KhalidOwlWalid/OwlKit-F103/OwlPCB_Notes/images/Pasted image 20261017075340.png

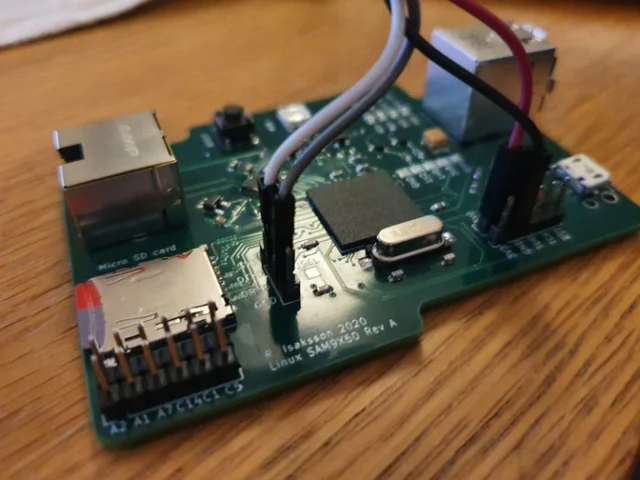
OwlPCB_Notes/images/Pasted image 20261017075340.png
