KhalidOwlWalid/OwlKit-F103/OwlPCB_Notes/First PCB.md

The objective of the first PCB is going to help me understand the embedded world. My learning objectives include:

## Hardware objectives
- SPI breakout
- I2C breakout
- 
- Implementing SPI logic to communicate with MEMS chip (ICM-20948 - 9 axis accelerometer, gyroscope, magnetometer)
- The PCB itself should be able to do CAN
- Use of trice program for debugging
- Debugging with the stm32 cli toolset
- Implementing shell sessions for better debugging capabilities
- Implementing a simple EKF
- USB-C debugging
- Use of SWD header
- Implementing my own bootloader(?) potentially?

The PCB should be able to output  its:
- x,y,z
- roll,pitch,heading

## Design Reference

#### USB-C
- https://hackaday.com/2023/08/07/all-about-usb-c-example-circuits/
