KhalidOwlWalid/OwlKit-F103/OwlPCB_Notes/Needs reviewing.md

# Power budgetting

# USB routing
- It is hard for me to route the USB because they basically overlap each other since each of them basically have 2 pins.
