KhalidOwlWalid/OwlKit-F103/OwlPCB_Notes/images/Pasted image 20261012213644.png

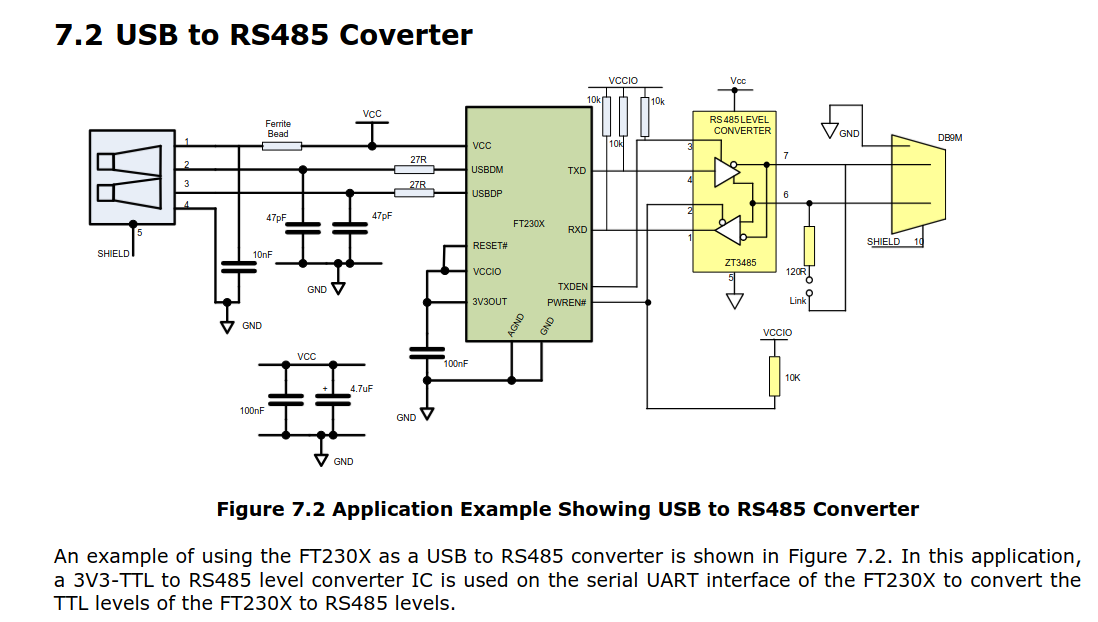
OwlPCB_Notes/images/Pasted image 20261012213644.png
