KhalidOwlWalid/OwlKit-F103/OwlPCB_Notes/images/Pasted image 20261012213755.png

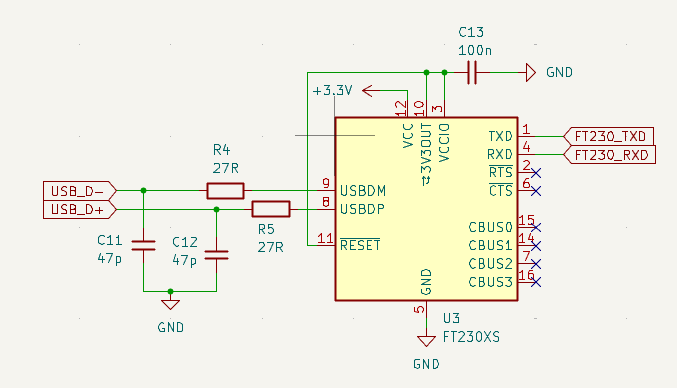
OwlPCB_Notes/images/Pasted image 20261012213755.png
