KhalidOwlWalid/OwlKit-F103/OwlPCB_Notes/images/Pasted image 20261013105958.png

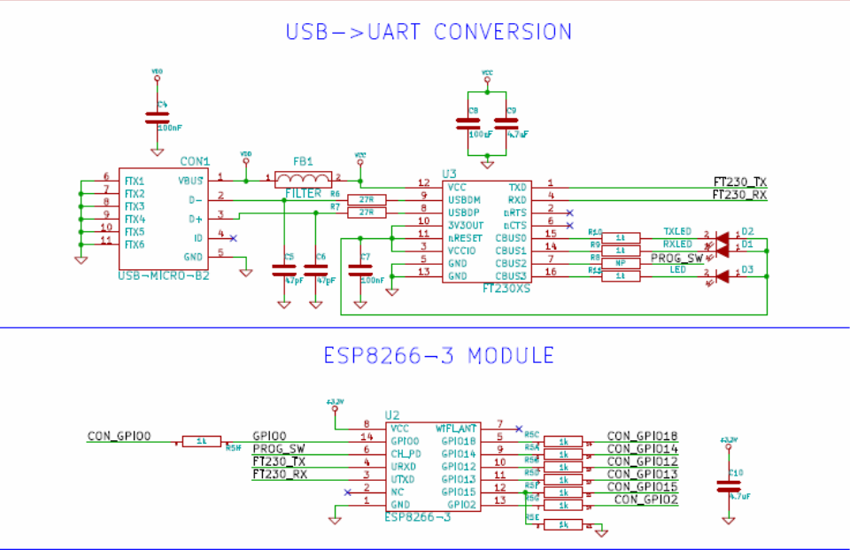
OwlPCB_Notes/images/Pasted image 20261013105958.png
