KhalidOwlWalid/OwlKit-F103/OwlPCB_Notes/images/Pasted image 20261014154300.png

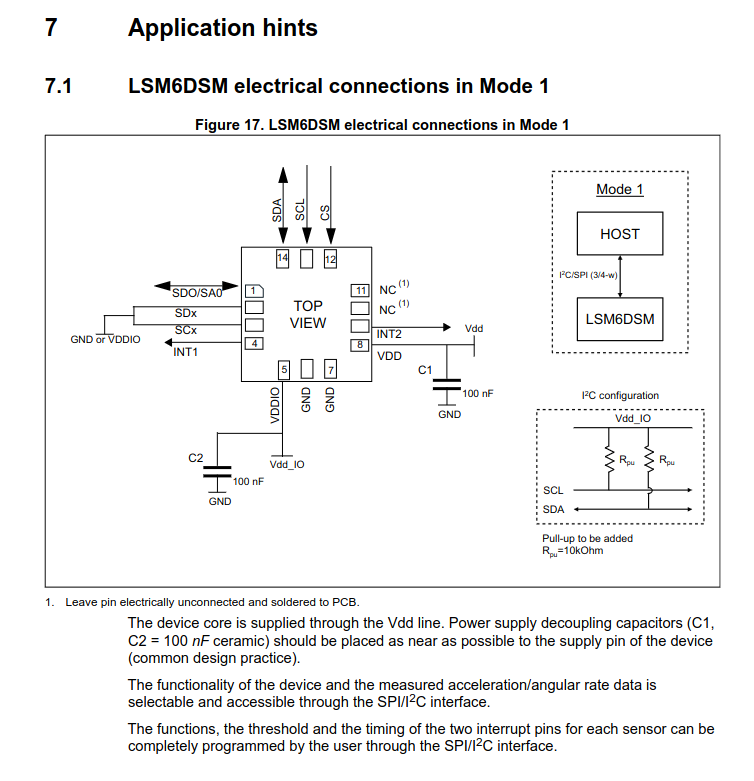
OwlPCB_Notes/images/Pasted image 20261014154300.png
