KhalidOwlWalid/OwlKit-F103/OwlPCB_Notes/images/Pasted image 20261014201545.png

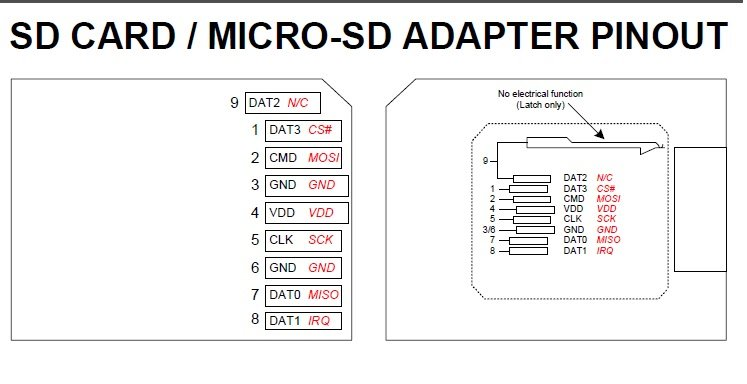
OwlPCB_Notes/images/Pasted image 20261014201545.png
