KhalidOwlWalid/OwlKit-F103/OwlPCB_Notes/images/Pasted image 20261015111348.png

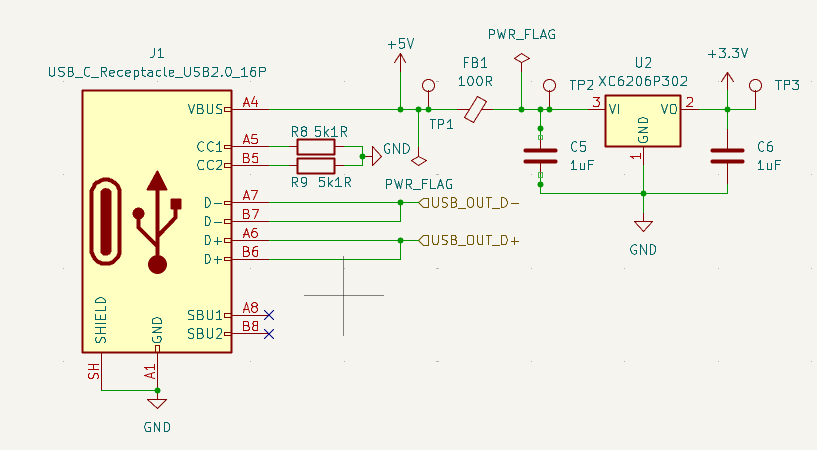
OwlPCB_Notes/images/Pasted image 20261015111348.png
