KhalidOwlWalid/OwlKit-F103/OwlPCB_Notes/images/Pasted image 20261015134140.png

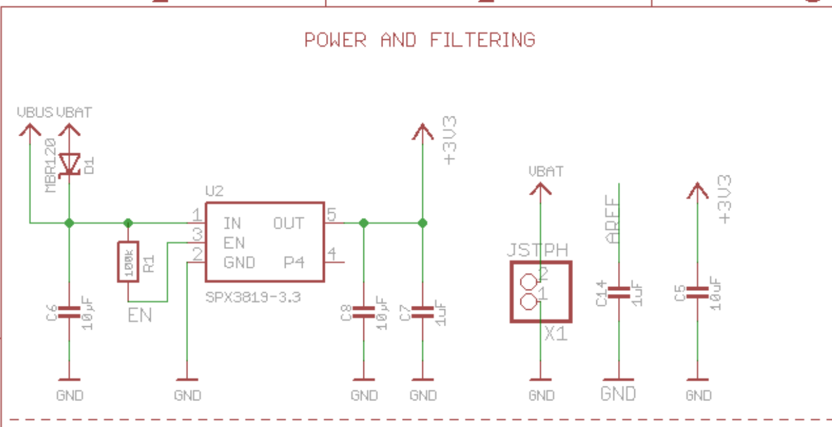
OwlPCB_Notes/images/Pasted image 20261015134140.png
