KhalidOwlWalid/OwlKit-F103/3d/SW_SPDT_CK_JS102011SAQN.STEP

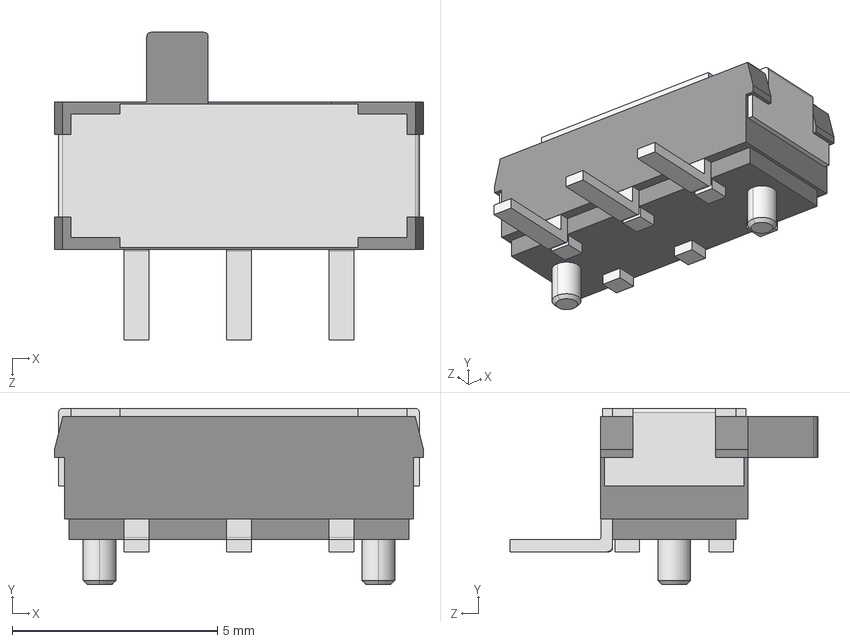
[picture p17: CAD file, 2026-11-11]
3d/SW_SPDT_CK_JS102011SAQN.STEP
9.00 x 4.30 x 7.50 mm
