KhalidOwlWalid/OwlKit-F103/owl_v1.kicad_pcb

## KiCad design owl_v1.kicad_pcb (2026-11-12)

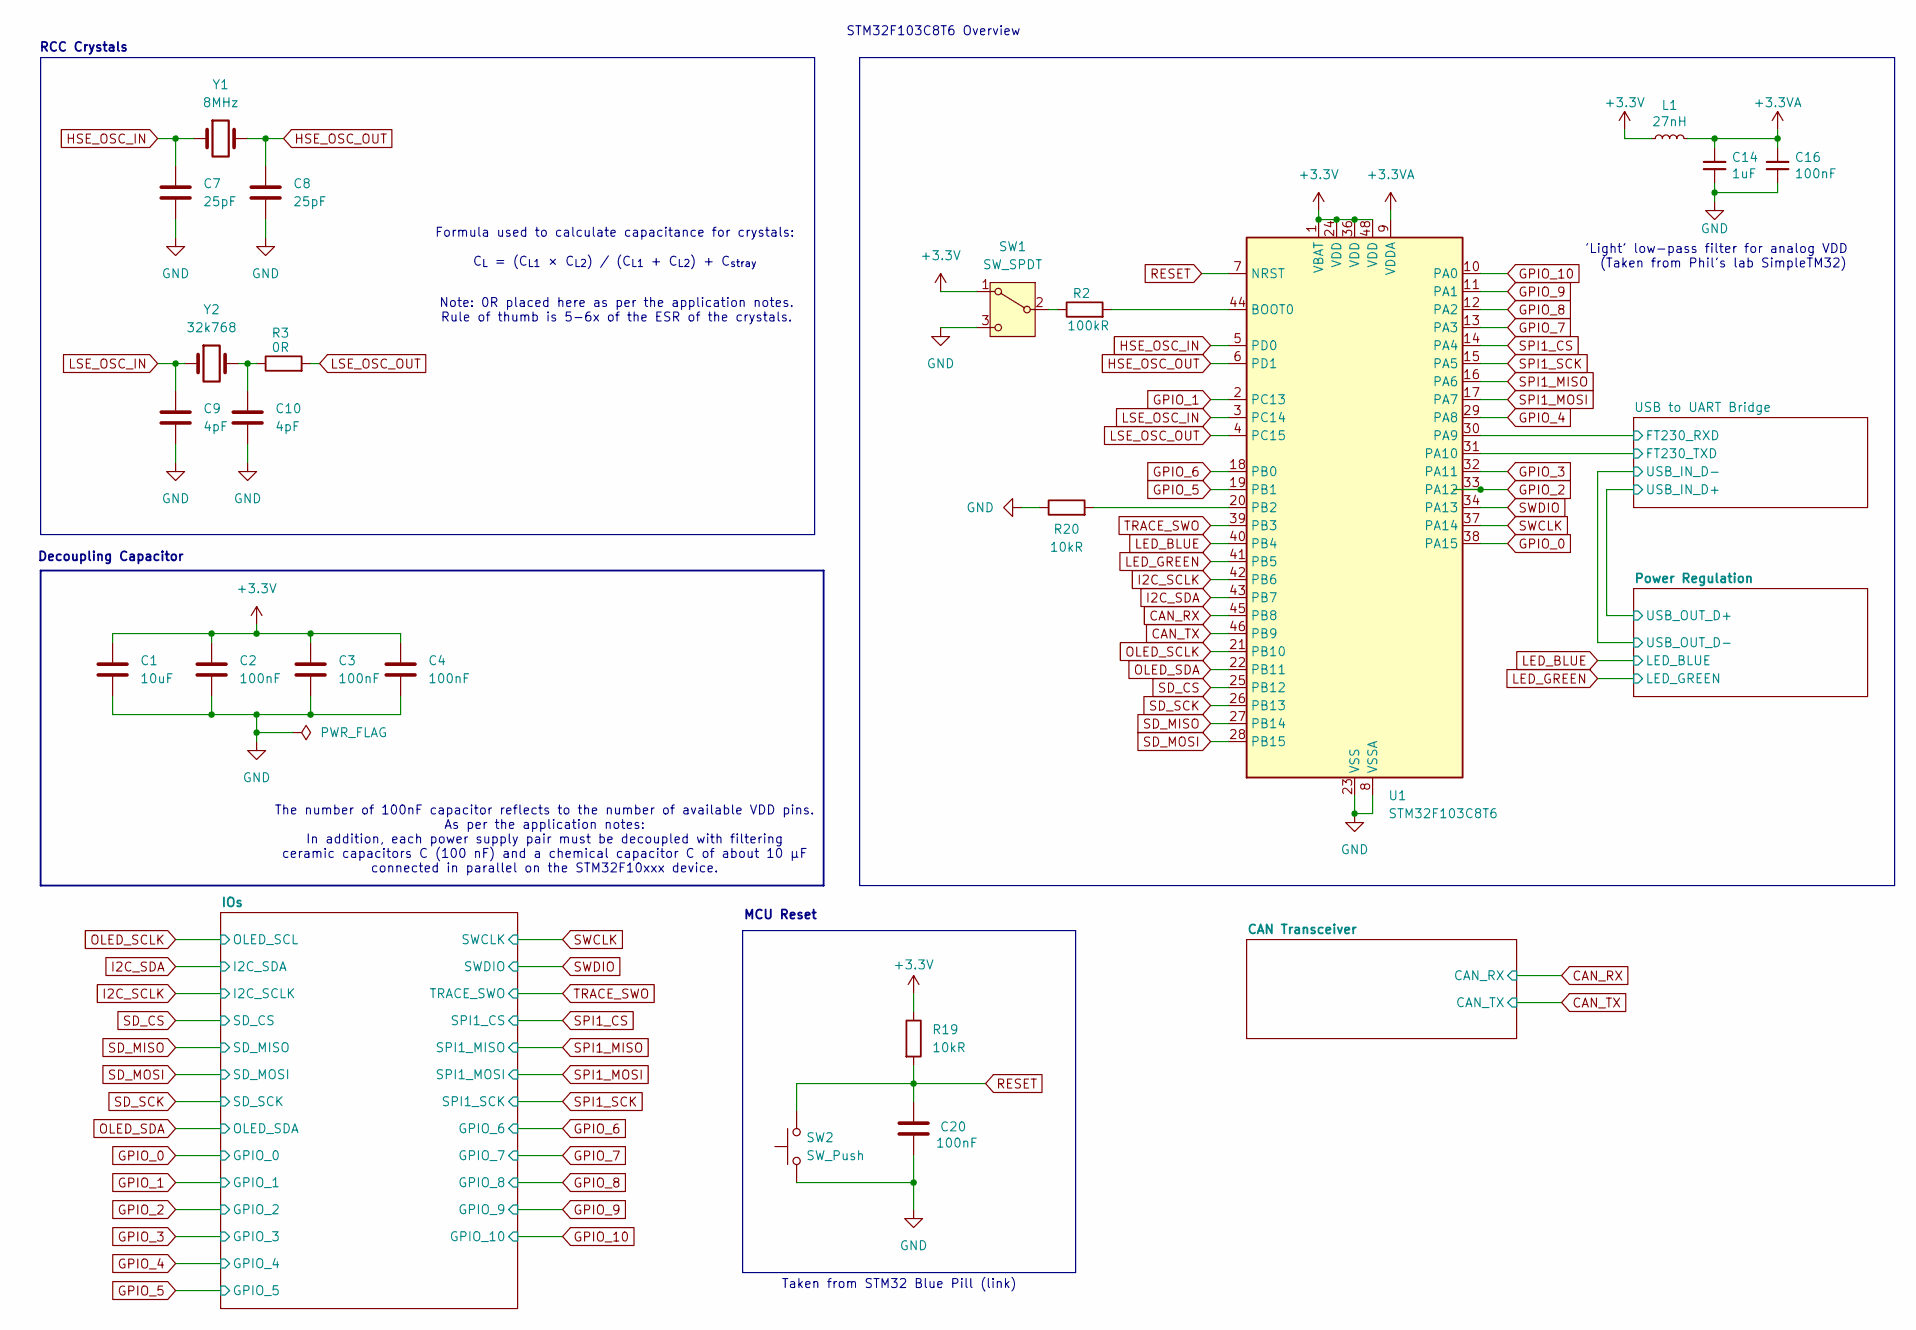
[picture p24: schematic owl_v1.kicad_sch]

Parts:
C1: 10uF; C_0603_1608Metric
C2, C3, C4, C20: 100nF; C_0603_1608Metric
C7, C8: 25pF; C_0603_1608Metric
C9, C10: 4pF; C_0603_1608Metric
C14: 1uF; C_0603_1608Metric; LCSC Part # C52923
C16: 100nF; C_0603_1608Metric; LCSC Part # C1525
L1: 27nH; L_0603_1608Metric; LCSC Part # C18830
R2: 100kR; R_0603_1608Metric
R3: 0R; R_0603_1608Metric
R19, R20: 10kR; R_0603_1608Metric
SW1: SW_SPDT; SW_SPDT_CK_JS102011SAQN
SW2: SW_Push; SW_PUSH_6mm
U1: STM32F103C8T6; LQFP-48_7x7mm_P0.5mm
Y1: 8MHz; Crystal_SMD_HC49-SD
Y2: 32k768; Crystal_SMD_MicroCrystal_CC8V-T1A-2Pin_2.0x1.2mm_HandSolder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

Connections:
+3.3V: C1.1, C2.1, C3.1, C4.1, L1.1, R19.1, SW1.1 (A), U1.1 (VBAT), U1.24 (VDD), U1.36 (VDD), U1.48 (VDD); also elsewhere on the board
+3.3VA: C14.1, C16.1, L1.2, U1.9 (VDDA)
/owl_v1/USB to UART Bridge/FT230_RXD: U1.30 (PA9); also elsewhere on the board
/owl_v1/USB to UART Bridge/FT230_TXD: U1.31 (PA10); also elsewhere on the board
CAN_RX: U1.45 (PB8); also elsewhere on the board
CAN_TX: U1.46 (PB9); also elsewhere on the board
GND: C1.2, C2.2, C3.2, C4.2, C7.2, C8.2, C9.2, C10.2, C14.2, C16.2, C20.1, R20.1, SW1.3 (C), SW2.1, U1.8 (VSSA), U1.23 (VSS), U1.35 (VSS), U1.47 (VSS); also elsewhere on the board
GPIO_0: U1.38 (PA15); also elsewhere on the board
GPIO_1: U1.2 (PC13); also elsewhere on the board
GPIO_2: U1.33 (PA12); also elsewhere on the board
GPIO_3: U1.32 (PA11); also elsewhere on the board
GPIO_4: U1.29 (PA8); also elsewhere on the board
GPIO_5: U1.19 (PB1); also elsewhere on the board
GPIO_6: U1.18 (PB0); also elsewhere on the board
GPIO_7: U1.13 (PA3); also elsewhere on the board
GPIO_8: U1.12 (PA2); also elsewhere on the board
GPIO_9: U1.11 (PA1); also elsewhere on the board
GPIO_10: U1.10 (PA0); also elsewhere on the board
HSE_OSC_IN: C7.1, U1.5 (PD0), Y1.1
HSE_OSC_OUT: C8.1, U1.6 (PD1), Y1.2
I2C_SCLK: U1.42 (PB6); also elsewhere on the board
I2C_SDA: U1.43 (PB7); also elsewhere on the board
LED_BLUE: U1.40 (PB4); also elsewhere on the board
LED_GREEN: U1.41 (PB5); also elsewhere on the board
LSE_OSC_IN: C9.1, U1.3 (PC14), Y2.1
LSE_OSC_OUT: R3.2, U1.4 (PC15)
unnamed: C10.1, R3.1, Y2.2
unnamed: R2.1, SW1.2 (B)
unnamed: R2.2, U1.44 (BOOT0)
unnamed: R20.2, U1.20 (PB2)
OLED_SCLK: U1.21 (PB10); also elsewhere on the board
OLED_SDA: U1.22 (PB11); also elsewhere on the board
RESET: C20.2, R19.2, SW2.2, U1.7 (NRST)
SD_CS: U1.25 (PB12); also elsewhere on the board
SD_MISO: U1.27 (PB14); also elsewhere on the board
SD_MOSI: U1.28 (PB15); also elsewhere on the board
SD_SCK: U1.26 (PB13); also elsewhere on the board
SPI1_CS: U1.14 (PA4); also elsewhere on the board
SPI1_MISO: U1.16 (PA6); also elsewhere on the board
SPI1_MOSI: U1.17 (PA7); also elsewhere on the board
SPI1_SCK: U1.15 (PA5); also elsewhere on the board
SWCLK: U1.37 (PA14); also elsewhere on the board
SWDIO: U1.34 (PA13); also elsewhere on the board
TRACE_SWO: U1.39 (PB3); also elsewhere on the board

Notes on the sheet:
MCU Reset
Formula used to calculate capacitance for crystals: C_{L} = (C_{L1} × C_{L2}) / (C_{L1} + C_{L2}) + C_{stray}
RCC Crystals
STM32F103C8T6 Overview
The number of 100nF capacitor reflects to the number of available VDD pins. As per the application notes: In addition, each power supply pair must be decoupled with filtering ceramic capacitors C (100 nF) and a chemical capacitor C of about 10 μF connected in parallel on the STM32F10xxx device.
Decoupling Capacitor
Taken from STM32 Blue Pill (link)
Note: 0R placed here as per the application notes. Rule of thumb is 5-6x of the ESR of the crystals.
'Light' low-pass filter for analog VDD (Taken from Phil's lab SimpleTM32)

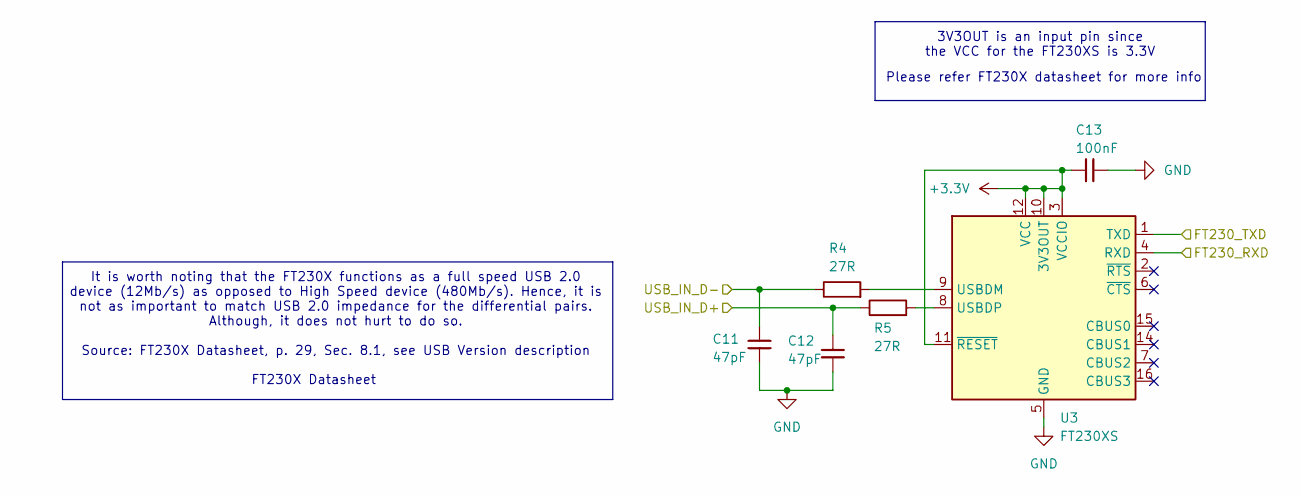
[picture p25: schematic usb_to_uart.kicad_sch]

Parts:
C11, C12: 47pF; C_0603_1608Metric
C13: 100nF; C_0603_1608Metric
R4, R5: 27R; R_0603_1608Metric
U3: FT230XS; SSOP-16_3.9x4.9mm_P0.635mm

Connections:
+3.3V: C13.2, U3.3 (VCCIO), U3.10 (3V3OUT), U3.11 (~RESET), U3.12 (VCC); also elsewhere on the board
/owl_v1/Power Regulation/USB_OUT_D+: C12.1, R5.1; also elsewhere on the board
/owl_v1/Power Regulation/USB_OUT_D-: C11.1, R4.1; also elsewhere on the board
/owl_v1/USB to UART Bridge/FT230_RXD: U3.4 (RXD); also elsewhere on the board
/owl_v1/USB to UART Bridge/FT230_TXD: U3.1 (TXD); also elsewhere on the board
GND: C11.2, C12.2, C13.1, U3.5 (GND), U3.13 (GND); also elsewhere on the board
unnamed: R4.2, U3.9 (USBDM)
unnamed: R5.2, U3.8 (USBDP)

Notes on the sheet:
Please refer FT230X datasheet for more info
3V3OUT is an input pin since the VCC for the FT230XS is 3.3V
FT230X Datasheet
It is worth noting that the FT230X functions as a full speed USB 2.0 device (12Mb/s) as opposed to High Speed device (480Mb/s). Hence, it is not as important to match USB 2.0 impedance for the differential pairs. Although, it does not hurt to do so. Source: FT230X Datasheet, p. 29, Sec. 8.1, see US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

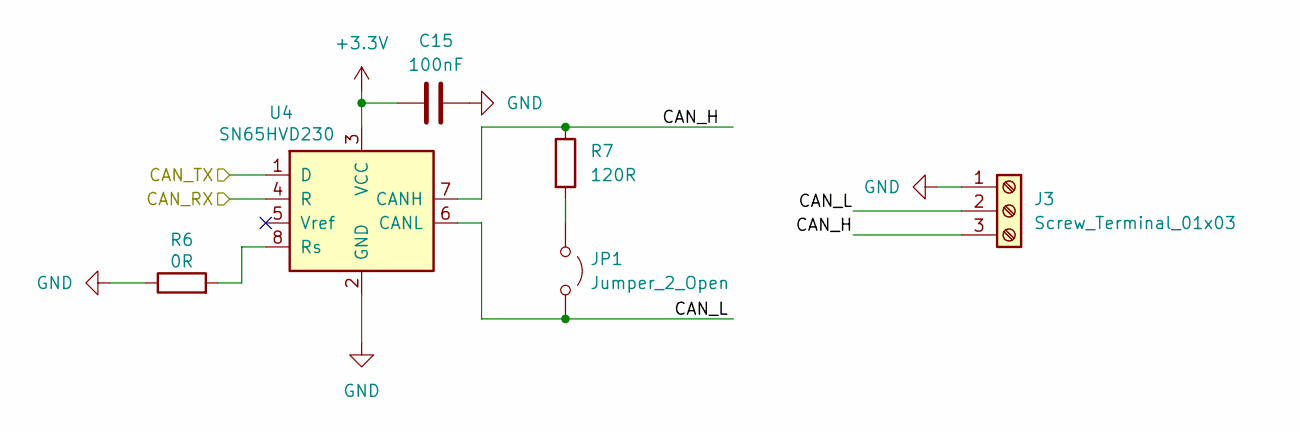
[picture p26: schematic can_controller.kicad_sch]

Parts:
C15: 100nF; C_0603_1608Metric
J3: Screw_Terminal_01x03; TerminalBlock_Phoenix_PT-1,5-3-3.5-H_1x03_P3.50mm_Horizontal
JP1: Jumper_2_Open; PinHeader_1x02_P2.54mm_Vertical
R6: 0R; R_0603_1608Metric
R7: 120R; R_0603_1608Metric
U4: SN65HVD230; SOIC-8_3.9x4.9mm_P1.27mm

Connections:
+3.3V: C15.1, U4.3 (VCC); also elsewhere on the board
/owl_v1/CAN Transceiver/CAN_H: J3.3, R7.1, U4.7 (CANH)
/owl_v1/CAN Transceiver/CAN_L: J3.2, JP1.2 (B), U4.6 (CANL)
CAN_RX: U4.4 (R); also elsewhere on the board
CAN_TX: U4.1 (D); also elsewhere on the board
GND: C15.2, J3.1, R6.1, U4.2 (GND); also elsewhere on the board
unnamed: JP1.1 (A), R7.2
unnamed: R6.2, U4.8 (Rs)

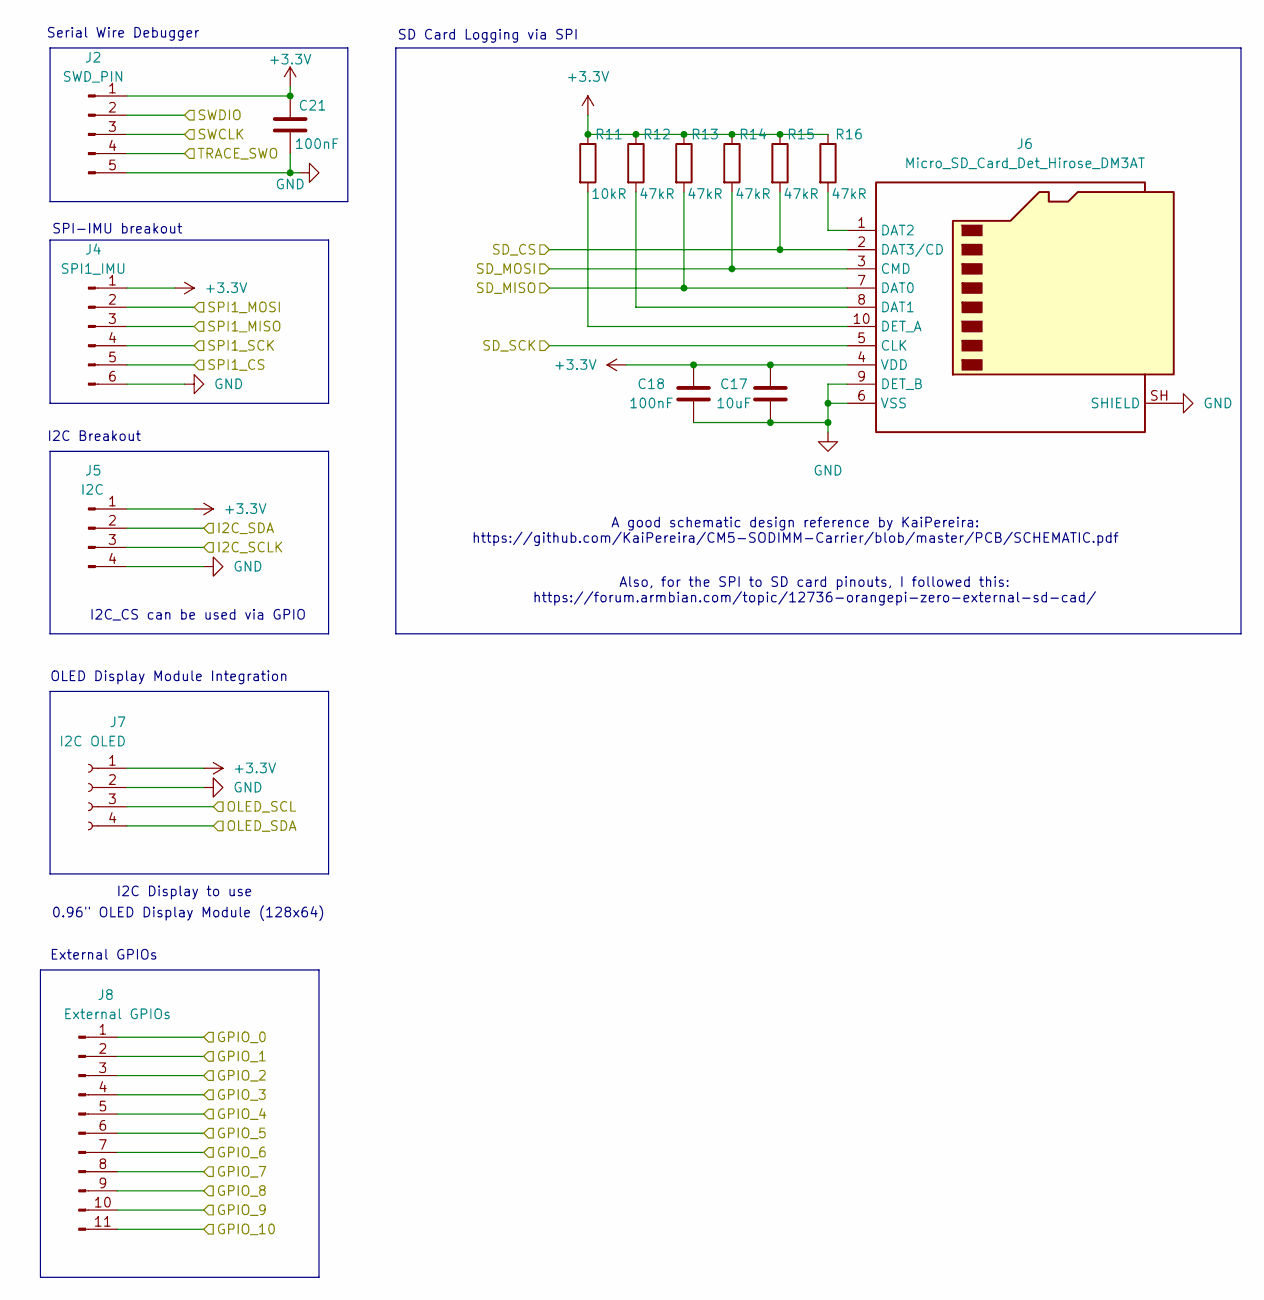
[picture p27: schematic GPIOs.kicad_sch]

Parts:
C17: 10uF; C_0603_1608Metric
C18, C21: 100nF; C_0603_1608Metric
J2: SWD_PIN; PinHeader_1x05_P2.54mm_Vertical
J4: SPI1_IMU; PinHeader_1x06_P2.54mm_Vertical
J5: I2C; PinHeader_1x04_P2.54mm_Vertical
J6: Micro_SD_Card_Det_Hirose_DM3AT; microSD_HC_Hirose_DM3AT-SF-PEJM5
J7: I2C OLED; PinSocket_1x04_P2.54mm_Vertical
J8: External GPIOs; PinHeader_1x11_P2.54mm_Vertical
R11: 10kR; R_0603_1608Metric
R12, R13, R14, R15, R16: 47kR; R_0603_1608Metric

Connections:
+3.3V: C17.1, C18.1, C21.1, J2.1, J4.1, J5.1, J6.4 (VDD), J7.1, R11.1, R12.1, R13.1, R14.1, R15.1, R16.1; also elsewhere on the board
GND: C17.2, C18.2, C21.2, J2.5, J4.6, J5.4, J6.6 (VSS), J6.9 (DET_B), J6.SH (SHIELD), J7.2; also elsewhere on the board
GPIO_0: J8.1; also elsewhere on the board
GPIO_1: J8.2; also elsewhere on the board
GPIO_2: J8.3; also elsewhere on the board
GPIO_3: J8.4; also elsewhere on the board
GPIO_4: J8.5; also elsewhere on the board
GPIO_5: J8.6; also elsewhere on the board
GPIO_6: J8.7; also elsewhere on the board
GPIO_7: J8.8; also elsewhere on the board
GPIO_8: J8.9; also elsewhere on the board
GPIO_9: J8.10; also elsewhere on the board
GPIO_10: J8.11; also elsewhere on the board
I2C_SCLK: J5.3; also elsewhere on the board
I2C_SDA: J5.2; also elsewhere on the board
unnamed: J6.8 (DAT1), R12.2
unnamed: J6.1 (DAT2), R16.2
unnamed: J6.10 (DET_A), R11.2
OLED_SCLK: J7.3; also elsewhere on the board
OLED_SDA: J7.4; also elsewhere on the board
SD_CS: J6.2 (DAT3/CD), R15.2; also elsewhere on the board
SD_MISO: J6.7 (DAT0), R13.2; also elsewhere on the board
SD_MOSI: J6.3 (CMD), R14.2; also elsewhere on the board
SD_SCK: J6.5 (CLK); also elsewhere on the board
SPI1_CS: J4.5; also elsewhere on the board
SPI1_MISO: J4.3; also elsewhere on the board
SPI1_MOSI: J4.2; also elsewhere on the board
SPI1_SCK: J4.4; also elsewhere on the board
SWCLK: J2.3; also elsewhere on the board
SWDIO: J2.2; also elsewhere on the board
TRACE_SWO: J2.4; also elsewhere on the board

Notes on the sheet:
Also, for the SPI to SD card pinouts, I followed this: https://forum.armbian.com/topic/12736-orangepi-zero-external-sd-cad/
Serial Wire Debugger
External GPIOs
SD Card Logging via SPI
0.96" OLED Display Module (128x64)
I2C Breakout
I2C_CS can be used via GPIO
SPI-IMU breakout
OLED Display Module Integration
I2C Display to use
A good schematic design reference by KaiPereira: https://github.com/KaiPereira/CM5-SODIMM-Carrier/blob/master/PCB/SCHEMATIC.pdf

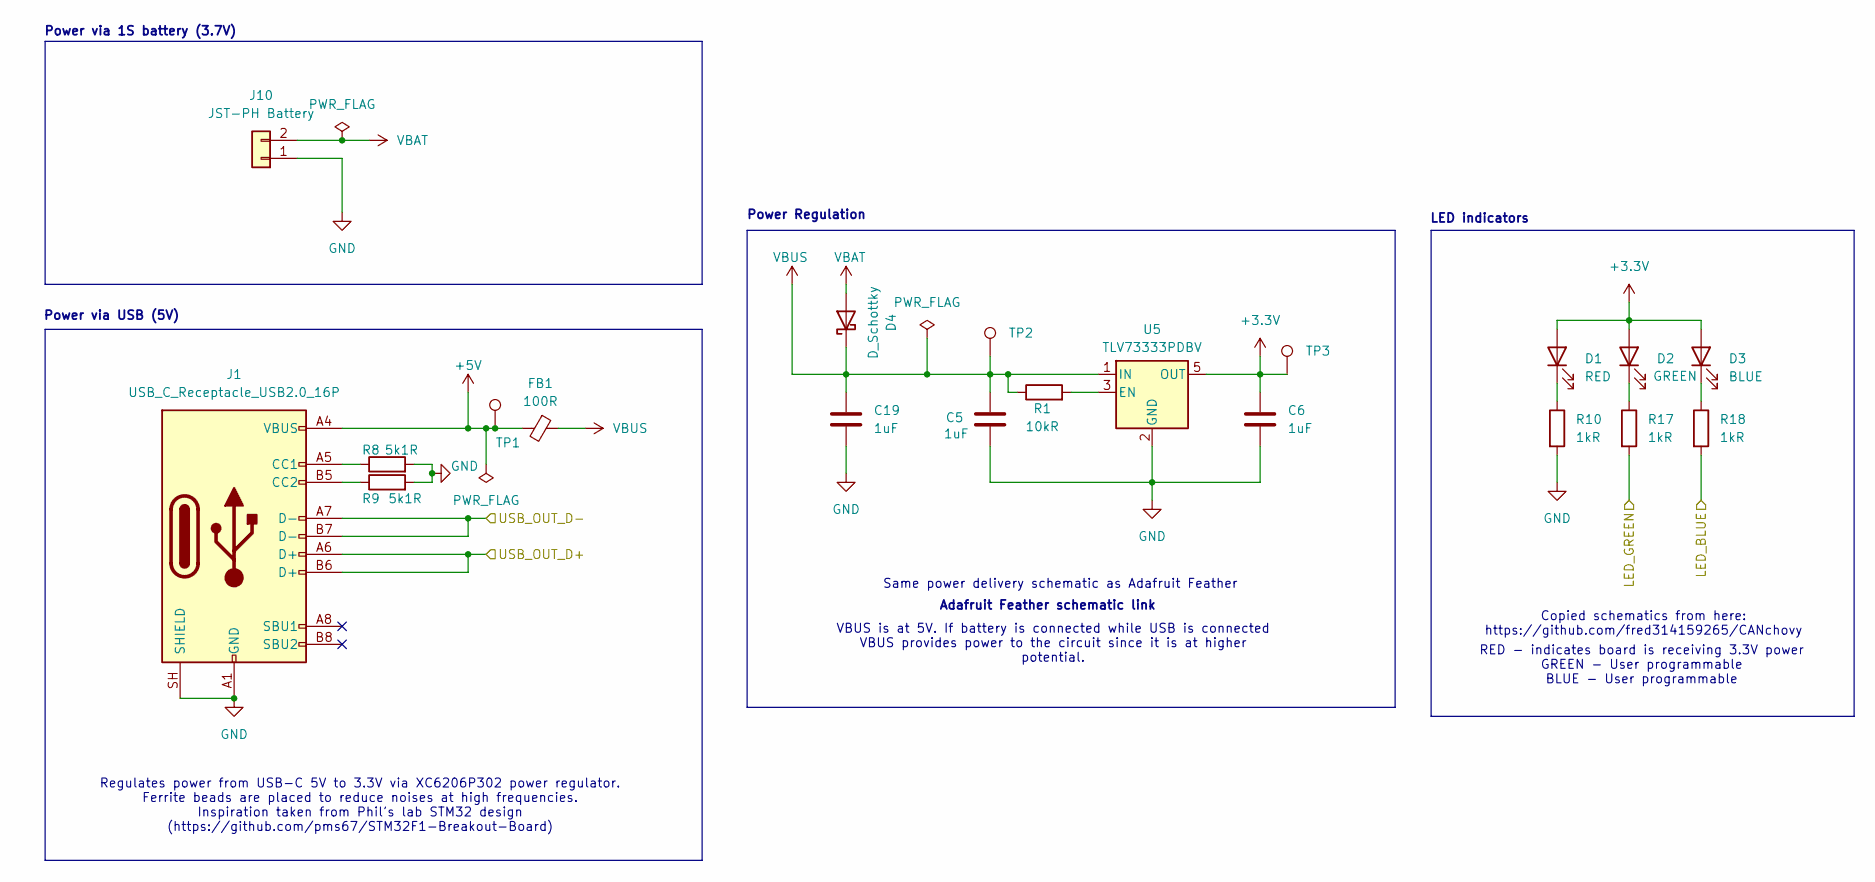
[picture p28: schematic usb_power_regulator.kicad_sch]

Parts:
C5, C6, C19: 1uF; C_0603_1608Metric
D1: RED; LED_0603_1608Metric
D2: GREEN; LED_0603_1608Metric
D3: BLUE; LED_0603_1608Metric
D4: D_Schottky; D_0603_1608Metric
FB1: 100R; L_0603_1608Metric
J1: USB_C_Receptacle_USB2.0_16P; USB_C_Receptacle_GCT_USB4105-xx-A_16P_TopMnt_Horizontal
J10: JST-PH Battery; JST_PH_S2B-PH-K_1x02_P2.00mm_Horizontal
R1: 10kR; R_0603_1608Metric
R8, R9: 5k1R; R_0603_1608Metric
R10, R17, R18: 1kR; R_0603_1608Metric
TP1, TP2, TP3: TestPoint_Pad_D1.5mm
U5: TLV73333PDBV; SOT-23-5

Connections:
+3.3V: C6.1, D1.2 (A), D2.2 (A), D3.2 (A), TP3.1 (1_1), U5.5 (OUT); also elsewhere on the board
+5V: FB1.2, J1.A4 (VBUS), J1.A9 (VBUS), J1.B4 (VBUS), J1.B9 (VBUS), TP1.1 (1_1)
/owl_v1/Power Regulation/USB_OUT_D+: J1.A6 (D+), J1.B6 (D+); also elsewhere on the board
/owl_v1/Power Regulation/USB_OUT_D-: J1.A7 (D-), J1.B7 (D-); also elsewhere on the board
GND: C5.2, C6.2, C19.2, J1.A1 (GND), J1.A12 (GND), J1.B1 (GND), J1.B12 (GND), J1.SH (SHIELD), J10.1, R8.2, R9.2, R10.2, U5.2 (GND); also elsewhere on the board
LED_BLUE: R18.2; also elsewhere on the board
LED_GREEN: R17.2; also elsewhere on the board
unnamed: D1.1 (K), R10.1
unnamed: D2.1 (K), R17.1
unnamed: D3.1 (K), R18.1
unnamed: J1.A5 (CC1), R8.1
unnamed: J1.B5 (CC2), R9.1
unnamed: R1.2, U5.3 (EN)
VBAT: D4.2 (A), J10.2
VBUS: C5.1, C19.1, D4.1 (K), FB1.1, R1.1, TP2.1 (1_1), U5.1 (IN)

Notes on the sheet:
VBUS is at 5V. If battery is connected while USB is connected VBUS provides power to the circuit since it is at higher potential.
Same power delivery schematic as Adafruit Feather
LED indicators
RED - indicates board is receiving 3.3V power GREEN - User programmable BLUE - User programmable
Regulates power from USB-C 5V to 3.3V via XC6206P302 power regulator. Ferrite beads are placed to reduce noises at high frequencies. Inspiration taken from Phil's lab STM32 design (https://github.com/pms67/STM32F1-Breakout-Board)
Copied schematics from here: https://github.com/fred314159265/CANchovy
Power via USB (5V)
Power Regulation
Power via 1S battery (3.7V)
Adafruit Feather schematic link

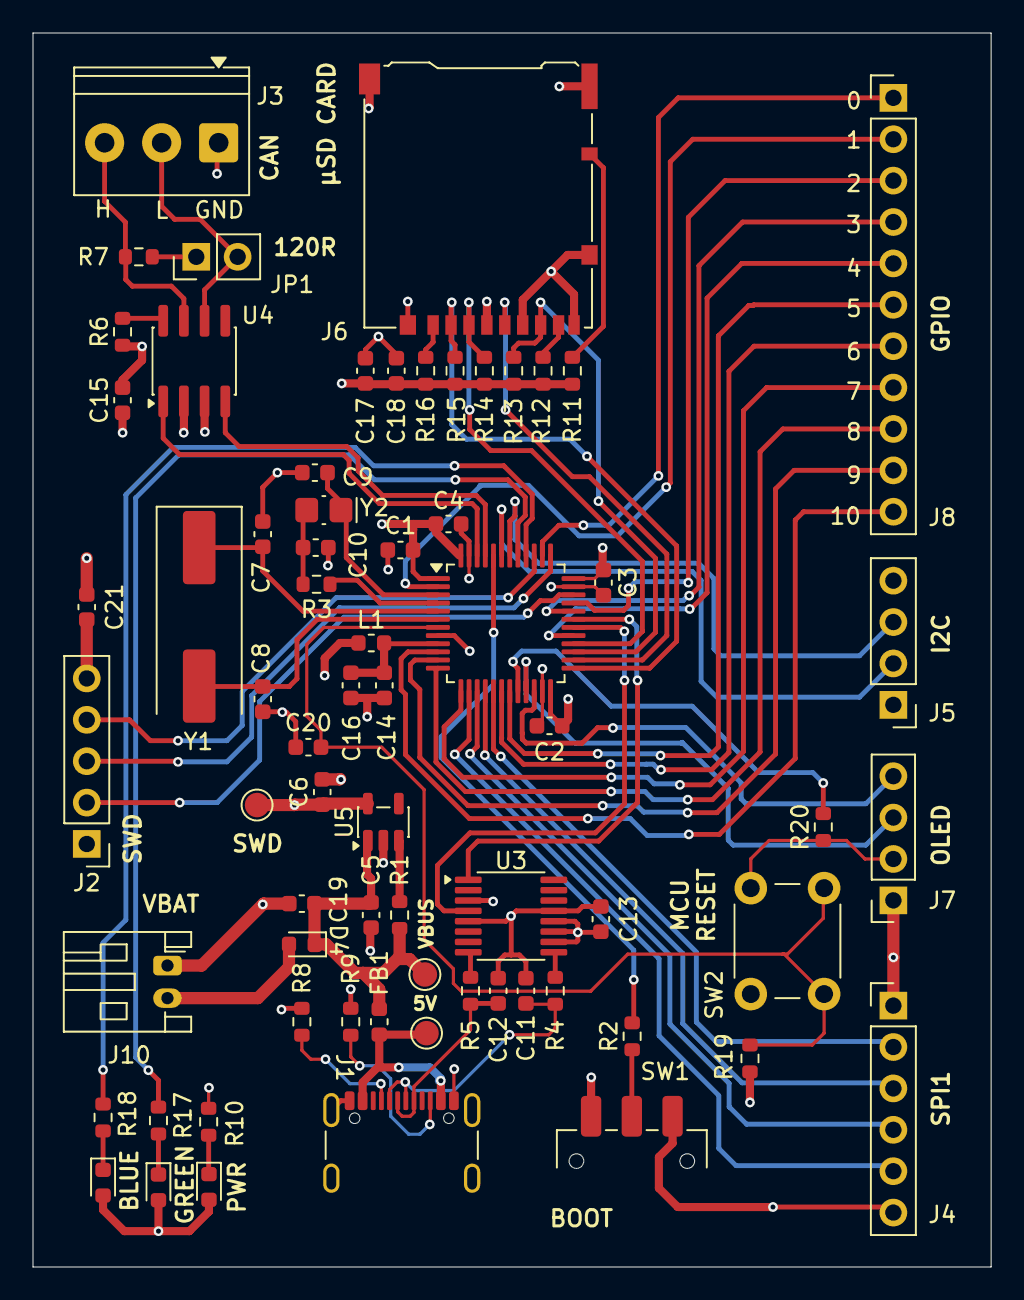
[picture p29: board owl_v1.kicad_pcb from above]

Board: 4 copper layers, 58.8 x 75.7 mm, 69 parts (1 on the bottom side), 64 nets.

Other parts of the board:
Owl Kit v0.1: LOGO
