KhalidOwlWalid/OwlKit-F103/(commit log)

2026-10-11 [chore] Initial commit
    [owl_v1.kicad_pcb, owl_v1.kicad_sch, untitled.kicad_sch]
2026-10-11 [feat] Add boot pin switch
    [owl_v1.kicad_sch]
2026-10-11 [chore] Add comments on why decoupling capacitor is used
    [owl_v1.kicad_sch]
2026-10-11 [feat] Integrate HSE and LSE crystal, populate global label for SWD
    [owl_v1.kicad_sch]
2026-10-11 [feat] Add HSE and LSE crystals for RCC
    [owl_v1.kicad_sch]
2026-10-12 [feat] Initial implementation of usb-uart bridge with FT230
    [owl_v1.kicad_sch, usb_uart.kicad_sch]
2026-10-13 [usb-uart] Connects VCC with 3V3OUT and VCCIO
    This needs to be done because FT230X is provided with 3.3V, if 3.3V is
    provided, as per the datasheet, 3V3OUT becomes an input and requires
    3.3V input. VCCIO now also needs to be fed with the same 3.3V as per the
    schematic. Although, in the schematic, VCC is not directly connected,
    but that is because in the RS485 application schematic, VCC is driven by
    5V and not 3.3V.
    [usb_uart.kicad_sch]
2026-10-13 [refactor] Refactor the schematics to use sub-sheets
    [GPIOs.kicad_sch, owl_v1.kicad_sch, sensors.kicad_sch, usb_power_regulator.kicad_sch, usb_to_uart.kicad_sch, usb_uart.kicad_sch]
2026-10-13 [feat] Add CAN transceiver SN65VHD230
    Also ran ERC checks and add some exclusion ERC for the FT230XS due to
    3V3OUT being an input pin rather than output pin
    [GPIOs.kicad_sch, can_controller.kicad_sch, owl_v1.kicad_sch, usb_power_regulator.kicad_sch, usb_to_uart.kicad_sch]
2026-10-13 [refactor] Change the CAN Tx and Rx from global to hierarchical label
    [can_controller.kicad_sch, owl_v1.kicad_sch]
2026-10-14 [feat] Add breakout for SPI1 for IMU
    [GPIOs.kicad_sch, owl_v1.kicad_sch, usb_power_regulator.kicad_sch]
2026-10-14 [feat] Add analogue filter
    The analogue filter has been copied from Phil's lab SimpleTM32
    [design_notes.kicad_sch, owl_v1.kicad_sch]
2026-10-14 [feat] Integrate MicroSD Card into the board with SPI2
    [GPIOs.kicad_sch, can_controller.kicad_sch, owl_v1.kicad_sch, usb_power_regulator.kicad_sch, usb_to_uart.kicad_sch]
2026-10-14 [fix] Add 5.1kR to CC1 and CC2 USB
    USB-C specification requires CC1 and CC2 to be connected to ground via a
    resistor for USB-C to USB-C power to work.
    [owl_v1.kicad_pcb, usb_power_regulator.kicad_sch]
2026-10-14 [feat] Add I2C breakout
    [GPIOs.kicad_sch, design_notes.kicad_sch, owl_v1.kicad_sch, usb_power_regulator.kicad_sch]
2026-10-15 [feat] Add OLED I2C breakout for display, Add general purpose GPIOs
    [GPIOs.kicad_sch, design_notes.kicad_sch, owl_v1.kicad_pcb, owl_v1.kicad_sch, usb_power_regulator.kicad_sch, usb_to_uart.kicad_sch]
2026-10-15 [feat] Add footprints for external GPIOs
    [GPIOs.kicad_sch, owl_v1.kicad_sch]
2026-10-15 [refactor] Remove GPIO12 and GPIO13 for LED green and blue
    [GPIOs.kicad_sch, design_notes.kicad_sch, owl_v1.kicad_pcb, owl_v1.kicad_sch]
2026-10-15 [feat] Integrate external battery
    [GPIOs.kicad_sch, changelog.kicad_sch, design_notes.kicad_sch, owl_v1.kicad_pcb, owl_v1.kicad_sch, usb_power_regulator.kicad_sch, usb_to_uart.kicad_sch]
2026-10-16 [feat] Initial routing for the owl PCB
    [owl_v1.kicad_pcb, owl_v1.kicad_sch, usb_power_regulator.kicad_sch, usb_to_uart.kicad_sch]
2026-10-16 [feat] Finished routing power regulation
    [owl_v1.kicad_pcb]
2026-10-16 [refactor] Change pinouts for CAN screw terminal
    I need to change this because I am struggling to route this in the pcb
    editor
    [GPIOs.kicad_sch, can_controller.kicad_sch, owl_v1.kicad_pcb]
2026-10-17 [checkpoint] Checkpoint before I mess up my routing for the micro SD card
    [owl_v1.kicad_pcb]
2026-10-18 [checkpoint] Change from 2 layer to 4 layer PCB
    [GPIOs.kicad_sch, owl_v1.kicad_pcb]
2026-10-19 [feat] Routing for FT230X USB-UART
    [owl.kicad_sch, owl_v1.kicad_pcb, test.kicad_sch, untitled.kicad_sch, usb_to_uart.kicad_sch]
2026-10-19 [feat] Finished re-routing HSE, LSE and 3.3VA
    [owl_v1.kicad_pcb]
2026-10-19 [refactor] Board resizing, SWD moved to fit left side of the board
    [owl_v1.kicad_pcb]
2026-10-19 [feat] Finished routing for uSD card reader
    [owl_v1.kicad_pcb]
2026-10-19 [feat] Route most GPIO pins and SWD pins
    [owl_v1.kicad_pcb, owl_v1.kicad_sch]
2026-10-19 [feat] Connect 3.3V source to all pins requiring 3.3V
    [owl_v1.kicad_pcb]
2026-10-19 [refactor] Change how GPIO is routed
    [owl_v1.kicad_pcb]
2026-10-19 [refactor] Expanded the board to get more GPIOs to fit
    [owl_v1.kicad_pcb, owl_v1.kicad_sch]
2026-10-19 [chore] Cleanup GPIOs routing
    [owl_v1.kicad_pcb]
2026-10-19 [fix] Change the board setup constraints which I thought was already correct?
    [owl_v1.kicad_pcb]
2026-10-19 [fix] Change vias settings
    Change minimum diameter from 0.7mm to 0.6mm with 0.3mm hole size
    [owl_v1.kicad_pcb]
2026-10-20 [feat] Add custom design rule check for JLCPCB, finished routing the whole thing, DRC all clear
    Taken from here (https://github.com/labtroll/KiCad-DesignRules)
    [owl_v1.kicad_pcb]
2026-10-20 [feat] Add owl logo
    [owl_v1.kicad_pcb]
2026-10-20 [chore] Add labels with front silkscreen
    [owl_v1.kicad_pcb]
2026-11-11 [bugfix] Fix BOOT1 pin which was GPIO11, now have a pull-down
    [GPIOs.kicad_sch, owl_v1.kicad_sch]
2026-11-11 [chore] Change symbol and update schematic properly
    [GPIOs.kicad_sch, owl_v1.kicad_pcb, owl_v1.kicad_sch]
2026-11-11 [bugfix] Fix issue with 3d CAD model for boot switch, initial re-routing for new components
    [SW_SPDT_CK_JS102011SAQN.STEP, owl_v1.kicad_sch]
2026-11-11 [chore] Finished routing new components
    [owl_v1.kicad_pcb]
2026-11-12 [chore] Update labelling, move RESET capacitor closer to mcu pin
    [owl_v1.kicad_pcb, owl_v1.kicad_sch]
